8n1/ESP8266-Tiny-Door-and-Window-Sensor/Schematic/Tiny-Door-and-Window-Sensor_v01_with-prog-features.png

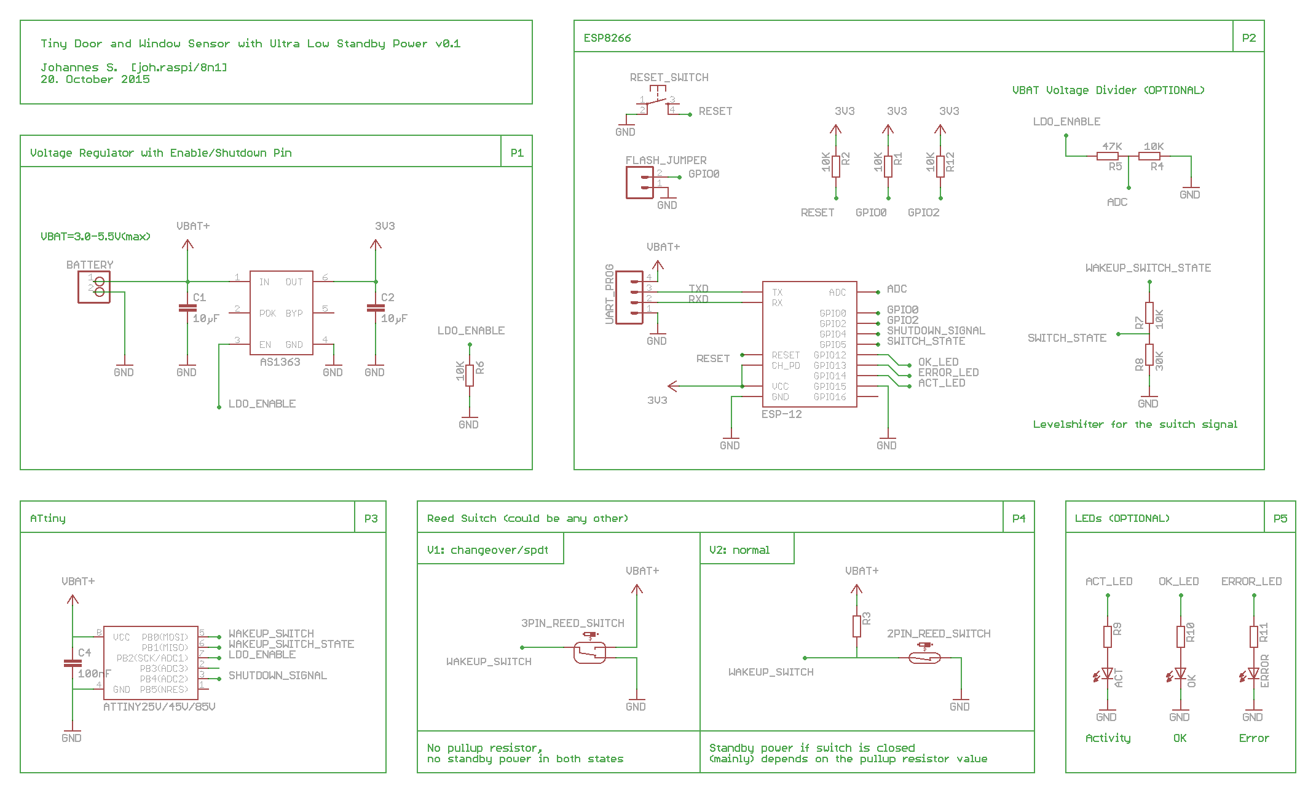
Schematic/Tiny-Door-and-Window-Sensor_v01_with-prog-features.png
