8n1/ESP8266-Tiny-Door-and-Window-Sensor/Schematic/tiny-door-and-window-sensor_v03.png

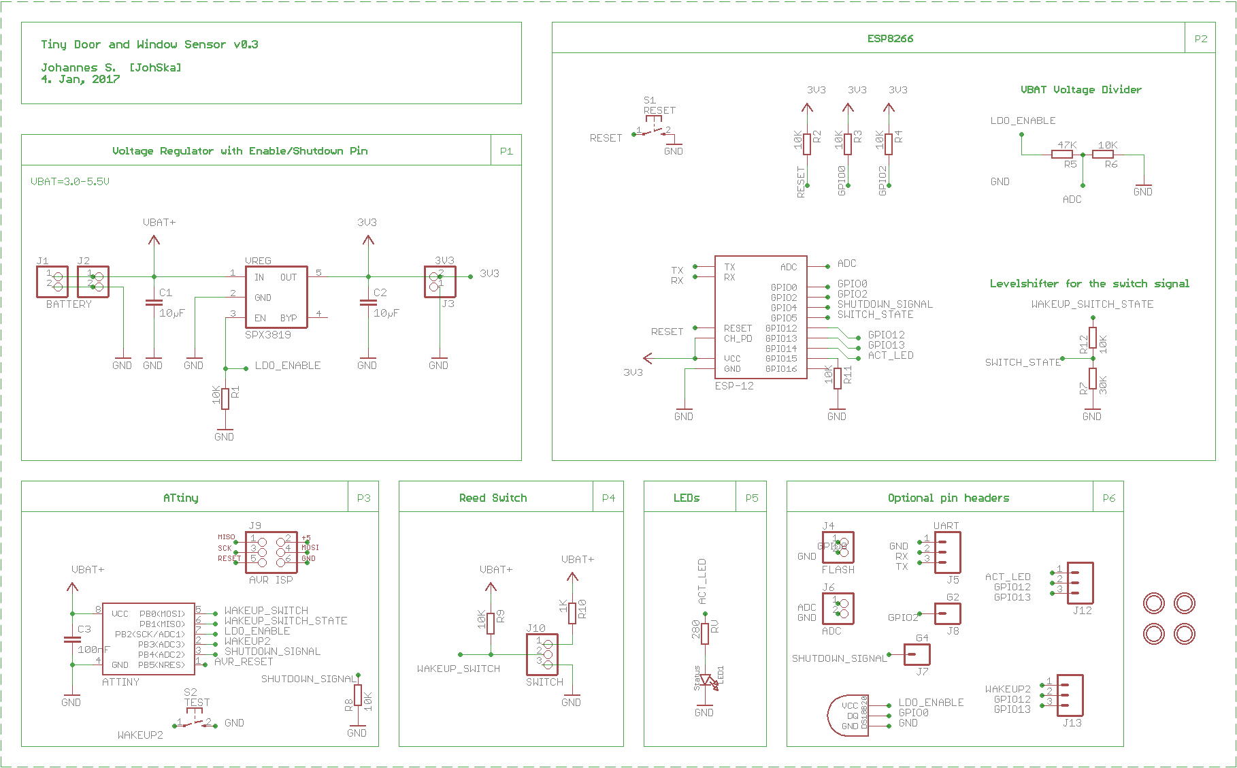
Schematic/tiny-door-and-window-sensor_v03.png
