8n1/ESP8266-Tiny-Door-and-Window-Sensor/(threads)

Thread 1 (2016-06-01):

Some info

Hydro8, 2016-06-01:
Hi

Sorry i don't understand deutsch so i can't find some informations :

- how much does it consume during wake up ?

- how long does it take to send open state to a service ?

- do you have any update on your PCB ?

Great job for your very low consumption !

8n1, 2016-06-02:
Hi
* Around 80mA avarage. (This is what the esp8266 needs, The ATtiny only needs a few hunderd µA)
* Usualy about 3-5 seconds. If "GET_WIFI_STRENGTH" is activated about 5-7 seconds. But varies, sometimes a bit longer.
* Yes I also made a second version of the pcb(but didn't tested it yet). I want to update everything on the weekend.

Thanks, you are welcome!

onpagithub, 2017-01-20:
Hi,
it is very interesting project. I§m trying do the same without any external micro, just with ESP8266. But I would like also play with your strategy. Could you share your PCB with me ? It will be helpful for me, I'm beginner in PCB design.

Thanks,
Ondrej

8n1, 2017-01-23:
Hi

I just uploaded the PCB.

reichley, 2017-01-26:
Just flashed your attiny code to my attiny25 and implemented your vreg_shutdown in my code uploaded to a wemos d1 mini. Works like a champ! One question...Have you thought of using a watchdog timer loop as an alternative to the 2nd interrupt? For example, if motion/door opens or closes OR if after 5 minutes, come out of sleep and send info? How would I implement the watchdog interrupt in your attiny code?

Thread 3 (2017-05-14):

Voltage Reading Question

justinatomatic, 2017-05-14:
Quick question on the voltage reading part of the PCB design. Why is the voltage divider/ADC connected to LDO_ENABLE ? How does this give you a voltage reading? Shouldn't it be connected to VBAT+

Love the design overall I'm going to build a few and try a PIR variant.

Thread 4 (2017-10-10):

Built it

johnjore, 2017-10-10:
Thanks for making it available. I built the v0.1 edition and used an 18650 battery, rated @ 2600mAh, (could be wrong / fake). I made the following changes:
* No LED's
* No voltage (battery) readings
* 3 wire reed sensor
* Used http://www.hobbytronics.co.uk/s7v8f3-3v3-regulator as I can't solder surface mounted components

Battery lasted 5 months with the sensor attached to the front door, the circuit stopped working with battery @ 2.3V, which exceeds the voltage regulators specifications.

I paired it with a DS90 sensor and monitored both to see how reliable each of them were, and I think for 99% of the time, both were identical. The ESP would occasionally drop a "CLOSED" signal, if open/closed happened quickly enough.

For this reason I think a watchdog timer waking up the device every x minutes, and reading the current state, would probably be a good idea.

While I had hoped for 12 months of running time, I'll need to see if the battery holds the promised capacity, and see if its possible to trim the timings to lower power usage.

Do you have any data for real-life running of your own?

filipre, 2018-10-21:
Now that over one year has passed, is there any update from your side 🙂?

johnjore, 2018-10-25:
Yes  🙂

I trimmed the timings a little and added period wake-ups. Here is a graph of one of the sensors. Ignore the reported voltage numbers, its off due to poor calculations compared to resistor values used.

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

JJ

Thread 5 (2017-10-21):

readme Link ins Forum

umbm, 2017-10-21:
Hallo,

der Link ins deutsche RaspberryPi-Forum ist nach der Umstellung dort nicht mehr aktuell.
Ich habe ihn hier gefunden:
https://forum-raspberrypi.de/forum/thread/24097-esp8266-tuer-und-fenster-sensor-alarm-mit-sehr-geringem-standby-verbrauch-1%C2%B5a/

filipre, 2018-10-21:
Also notice that the schematics in the readme are for v0.1 and that there already exist more recent ones here: https://github.com/8n1/ESP8266-Tiny-Door-and-Window-Sensor/blob/master/Schematic/tiny-door-and-window-sensor_v03.png

Thread 8 (2018-12-15):

tiny-door-and-window-sensor_v03 Fehler in Shematic

Hardy4711, 2018-12-15:
Hallo JohsKa,
vielen Dank für Deine Mühe und die Veröffentlichung Deines Projektes.
Seit einiger Zeit ist gibt es wohl kaum Entwicklungen. Vielleicht kann ich dass ja ändern.

Ich glaube, dass in der  v0.3 Schematic einen Feheler gefunden habe:
- J7: Nicht G4 sondern G5 (.Switch_State)

- G5 Durchkontaktierung: nicht G5 sondern G4

Ich häge mal mein korrektiertes Bild an.

Viele Grüß und ein frohes Fest !!!
Hardy
[Visio-TinyDoor-and-Window-Sensor-PCB.pdf](https://github.com/8n1/ESP8266-Tiny-Door-and-Window-Sensor/files/2683110/Visio-TinyDoor-and-Window-Sensor-PCB.pdf)

Closed 2018-12-15.

Thread 9 (2018-12-15):

tiny-door-and-window-sensor_v03 Fehler in Shematic

Hardy4711, 2018-12-15:
Hallo JohsKa,
vielen Dank für
[Visio-TinyDoor-and-Window-Sensor-PCB.pdf](https://github.com/8n1/ESP8266-Tiny-Door-and-Window-Sensor/files/2683137/Visio-TinyDoor-and-Window-Sensor-PCB.pdf)
Deine Mühe und die Veröffentlichung Deines Projektes.
Seit einiger Zeit ist gibt es wohl kaum Entwicklungen. Vielleicht kann ich dass ja ändern.

Ich glaube, dass in der v0.3 Schematic einen Feheler gefunden habe:

    J7: Nicht G4 sondern G5 (.Switch_State)

    G5 Durchkontaktierung: nicht G5 sondern G4

Ich häge mal mein korrektiertes Bild an.

Viele Grüß und ein frohes Fest !!!
Hardy

Thread 10 (2022-10-31):

Can I get rid of Attiny

zhuzhihua422619, 2022-10-31:
Thanks for sharing ，can I remove the Attiny and directly switch_input to the EN pin of the ldo,  so that it is more energy efficient without the Attiny？
Can I get rid of Attiny if  Switch_input is a self-reset button  ?  My project is to use the self-reset button to remotely control the light   through   espnow

回复
