8n1/ESP8266-Tiny-Door-and-Window-Sensor/Schematic/Tiny-Door-and-Window-Sensor_v01_with-prog-features.sch

## EAGLE design Schematic/Tiny-Door-and-Window-Sensor_v01_with-prog-features.sch (2016-01-16)

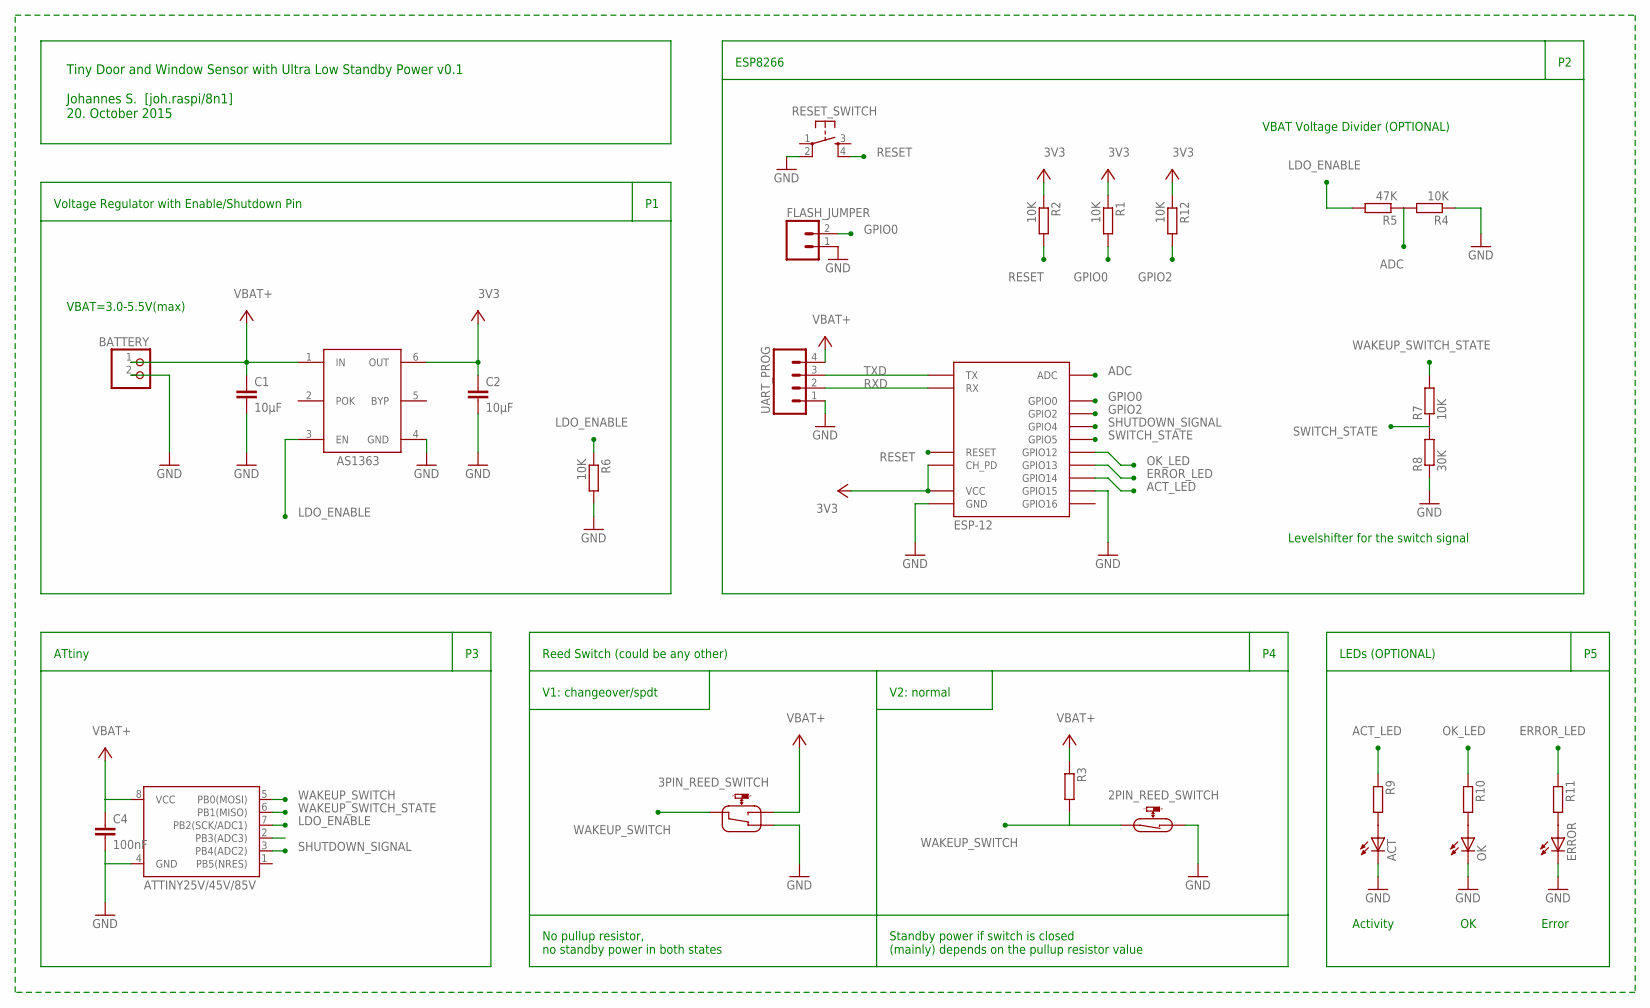
[picture p4: schematic Tiny-Door-and-Window-Sensor_v01_with-prog-features.sch]

Parts:
2PIN_REED_SWITCH: REED-SWITCH-CT10-1530-G1; CT10-G1
3PIN_REED_SWITCH: REED-SWITCH-NO-NC; MK6-8-C
ACT: LEDSML0805; SML0805
BATTERY: HEADER-1X2; 1X02_OVAL
C1, C2: 10µF; C0805
C4: 100nF; C0805
ERROR: LEDSML0805; SML0805
FLASH_JUMPER: M02PTH; 1X02
IC1: AS1363; SOT23-6
OK: LEDSML0805; SML0805
R1, R2, R4, R6, R7, R12: 10K; R0805
R3, R9, R10, R11: R-EU_R0805; R0805
R5: 47K; R0805
R8: 30K; R0805
RESET_SWITCH: TACTILE-SWITCH-PTH; TAC-SWITCH-PTH
U$2: ATTINY25V/45V/85V; SO08
U$3: ESP-12
UART_PROG: M04PTH; 1X04

Connections:
3V3: C2.1, IC1.6 (OUT), R1.1, R2.1, R12.1, U$3.CH_PD, U$3.VCC
ACT_LED: R9.1, U$3.GPIO14
ADC: R4.2, R5.1, U$3.ADC
ERROR_LED: R11.1, U$3.GPIO13
GND: 2PIN_REED_SWITCH.1, 3PIN_REED_SWITCH.NC, ACT.C, BATTERY.2, C1.2, C2.2, C4.2, ERROR.C, FLASH_JUMPER.1, IC1.4 (GND), OK.C, R4.1, R6.2, R8.1, RESET_SWITCH.2, U$2.4 (GND), U$3.GND, U$3.GPIO15, UART_PROG.1
GPIO0: FLASH_JUMPER.2, R1.2, U$3.GPIO0
GPIO2: R12.2, U$3.GPIO2
LDO_ENABLE: IC1.3 (EN), R5.2, R6.1, U$2.7 (PB2(SCK/ADC1))
unnamed: ACT.A, R9.2
unnamed: OK.A, R10.2
unnamed: ERROR.A, R11.2
OK_LED: R10.1, U$3.GPIO12
RESET: R2.2, RESET_SWITCH.4, U$3.RESET
RXD: U$3.RX, UART_PROG.2
SHUTDOWN_SIGNAL: U$2.3 (PB4(ADC2)), U$3.GPIO4
SWITCH_STATE: R7.1, R8.2, U$3.GPIO5
TIMER_RESET: U$2.2 (PB3(ADC3))
TXD: U$3.TX, UART_PROG.3
VBAT+: 3PIN_REED_SWITCH.NO, BATTERY.1, C1.1, C4.1, IC1.1 (IN), R3.1, U$2.8 (VCC), UART_PROG.4
WAKEUP_SWITCH: 2PIN_REED_SWITCH.2, 3PIN_REED_SWITCH.COM, R3.2, U$2.5 (PB0(MOSI))
WAKEUP_SWITCH_STATE: R7.2, U$2.6 (PB1(MISO))

Notes on the sheet:
No pullup resistor, no standby power in both states
Standby power if switch is closed (mainly) depends on the pullup resistor value
V1: changeover/spdt
V2: normal
ATtiny
Voltage Regulator with Enable/Shutdown Pin
ESP8266
Reed Switch (could be any other)
Tiny Door and Window Sensor with Ultra Low Standby Power v0.1 Johannes S. [joh.raspi/8n1] 20. October 2015
VBAT=3.0-5.5V(max)
VBAT Voltage Divider (OPTIONAL)
Levelshifter for the switch signal
Activity
LEDs (OPTIONAL)
Error
