8n1/ESP8266-Tiny-Door-and-Window-Sensor/Schematic/tiny-door-and-window-sensor_v03.sch

## EAGLE design Schematic/tiny-door-and-window-sensor_v03.sch (2017-02-03)

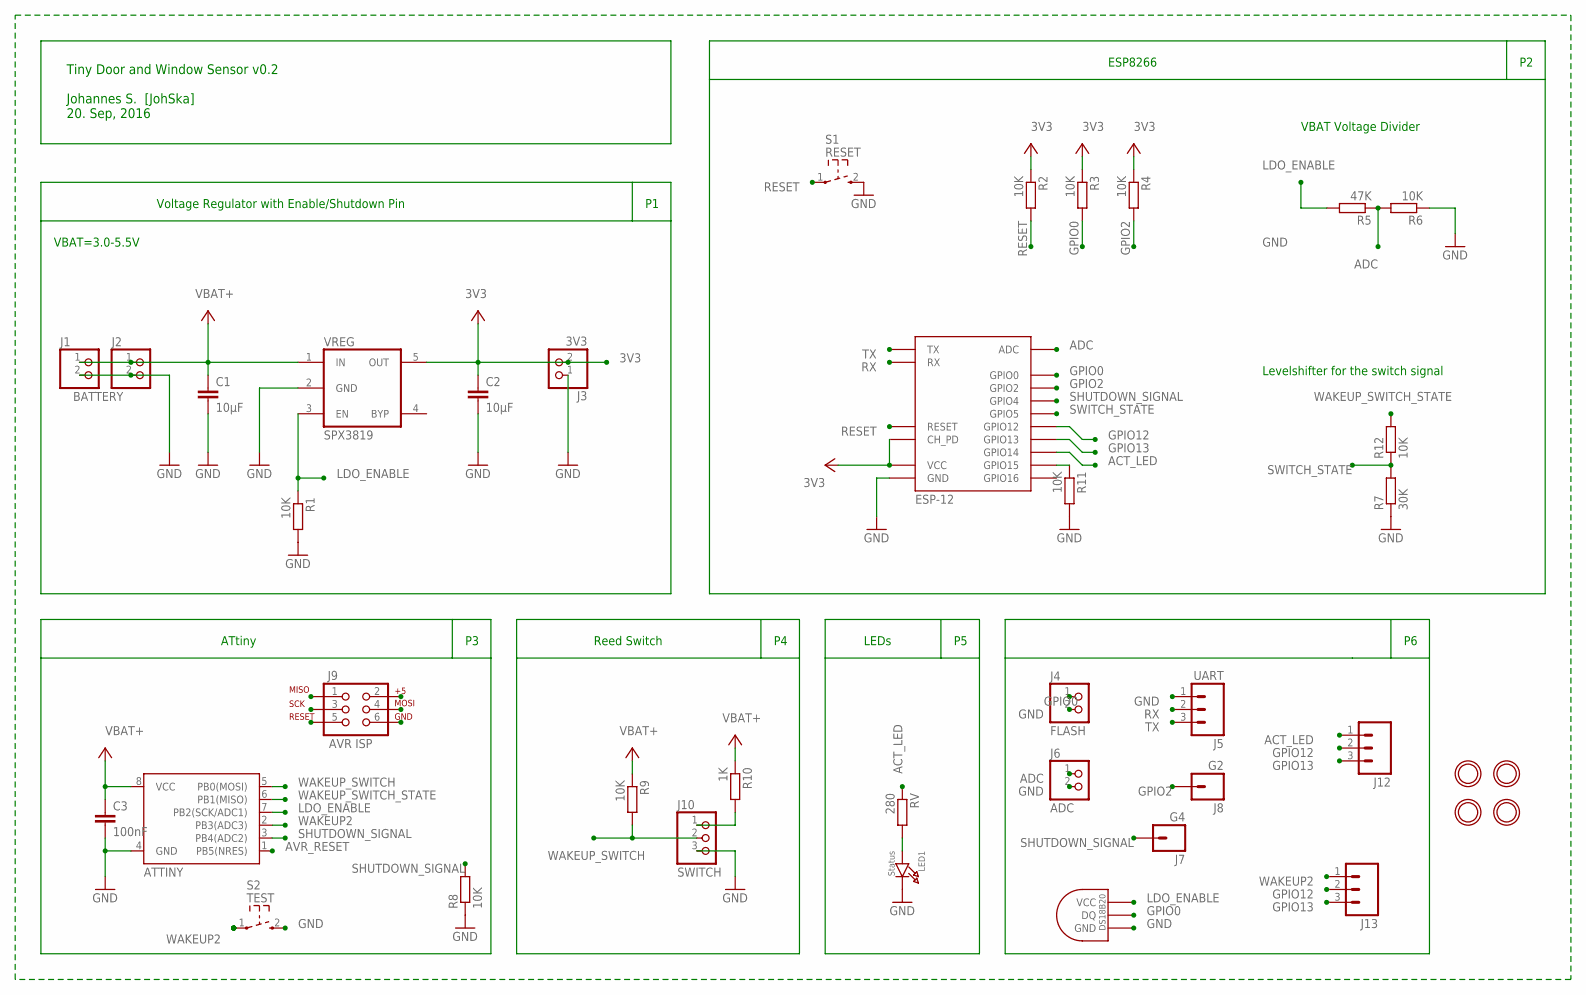
[picture p5: schematic tiny-door-and-window-sensor_v03.sch]

Parts:
C1, C2: 10µF; C0805
C3: 100nF; C0805
J1, J2: BATTERY; 1X02_OVAL
J3: 3V3; 1X02_ROUND
J4: FLASH; 1X02_ROUND
J5: UART; 1X03_NO_SILK
J6: ADC; 1X02_ROUND
J7: G4; 1X01NS
J8: G2; 1X01NS
J9: AVR ISP; 2X3
J10: SWITCH; 1X03
J12, J13: M031X03_NO_SILK; 1X03_NO_SILK
LED1: Status; CHIPLED_1206
R1, R2, R3, R4, R6, R8, R9, R11, R12: 10K; R0805
R5: 47K; R0805
R7: 30K; R0805
R10: 1K; R0805
RV: 280; R0805
S1: RESET; SW_TACT_3X6
S2: TEST; SW_TACT_3X6
U$1: DS1820TO92; DS1820
U$2: ATTINY; SO08-EIAJ
U$3: ESP-12
U$4, U$5, U$6, U$7: MOUNTINGHOLE2.5_THICK; MOUNTINGHOLE_2.5_PLATED_THICK
VREG: SPX3819; SOT-23-5

Connections:
3V3: C2.1, J3.2, R2.1, R3.1, R4.1, U$3.CH_PD, U$3.VCC, VREG.5 (OUT)
ACT_LED: J12.1, RV.1, U$3.GPIO14
ADC: J6.1, R5.1, R6.2, U$3.ADC
AVR_RESET: J9.5, U$2.1 (PB5(NRES))
GND: C1.2, C2.2, C3.2, J1.2, J2.2, J3.1, J4.2, J5.1, J6.2, J9.6, J10.3, LED1.C, R1.2, R6.1, R7.1, R8.1, R11.2, S1.2 (3), S2.2 (3), U$1.GND, U$2.4 (GND), U$3.GND, VREG.2 (GND)
GPIO0: J4.1, R3.2, U$1.DQ, U$3.GPIO0
GPIO2: J8.1, R4.2, U$3.GPIO2
GPIO12: J12.2, J13.2, U$3.GPIO12
GPIO13: J12.3, J13.3, U$3.GPIO13
LDO_ENABLE: J9.3, R1.1, R5.2, U$1.VDD (VCC), U$2.7 (PB2(SCK/ADC1)), VREG.3 (EN)
unnamed: R11.1, U$3.GPIO15
unnamed: LED1.A, RV.2
RESET: R2.2, S1.1, U$3.RESET
RX: J5.2, U$3.RX
SHUTDOWN_SIGNAL: J7.1, R8.2, U$2.3 (PB4(ADC2)), U$3.GPIO4
SWITCH_STATE: R7.2, R12.1, U$3.GPIO5
TX: J5.3, U$3.TX
VBAT+: C1.1, C3.1, J1.1, J2.1, J9.2, R9.1, R10.1, U$2.8 (VCC), VREG.1 (IN)
VBAT+_R: J10.1, R10.2
WAKEUP2: J13.1, S2.1, U$2.2 (PB3(ADC3))
WAKEUP_SWITCH: J9.4, J10.2, R9.2, U$2.5 (PB0(MOSI))
WAKEUP_SWITCH_STATE: J9.1, R12.2, U$2.6 (PB1(MISO))

Notes on the sheet:
ATtiny
Voltage Regulator with Enable/Shutdown Pin
ESP8266
Reed Switch
Tiny Door and Window Sensor v0.2 Johannes S. [JohSka] 20. Sep, 2016
VBAT=3.0-5.5V
VBAT Voltage Divider
Levelshifter for the switch signal
LEDs
