8n1/ESP8266-Tiny-Door-and-Window-Sensor/(commit log)

2016-01-16 initial upload
    [Tiny-Door-and-Window-Sensor_v01_with-prog-features.sch]
2017-01-23 PCB added
2017-02-03 update 2017 1/2
    [tiny-door-and-window-sensor_v03.sch]
2017-02-05 code optimized; rssi fixed
    [tiny_door_and_window_sensor_-_mqtt.ino]
